frozen-signal/Apple_IIe_IOU_3V3/(notices)

Notices in the files:
IOU_3V3.kicad_pcb:
Copyright © 2025 by:
Frozen Signal
